popescudragosviorel-lgtm/intelligent-hybrid-power-supply/README.md

# intelligent-hybrid-power-supply
Hybrid power supply system with ESP32-based monitoring and intelligent source switching.
