popescudragosviorel-lgtm/intelligent-hybrid-power-supply/scehma electrica.f.png

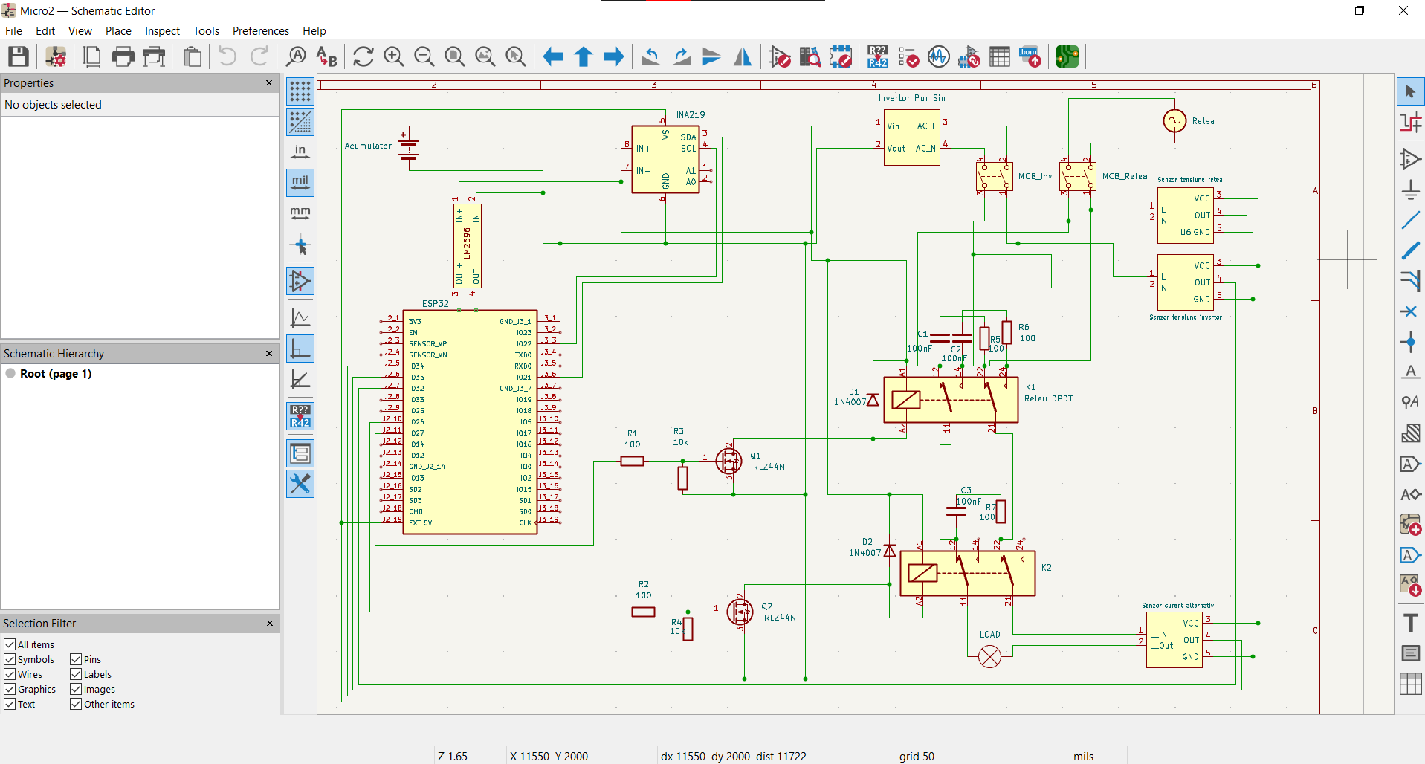
scehma electrica.f.png
