popescudragosviorel-lgtm/intelligent-hybrid-power-supply/schema bloc 2.png

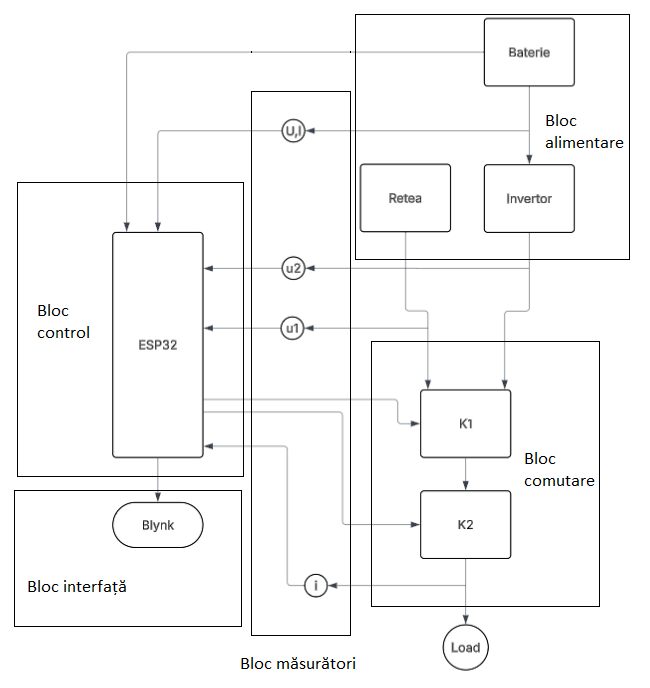
schema bloc 2.png
