popescudragosviorel-lgtm/intelligent-hybrid-power-supply/schma generala firmware.png

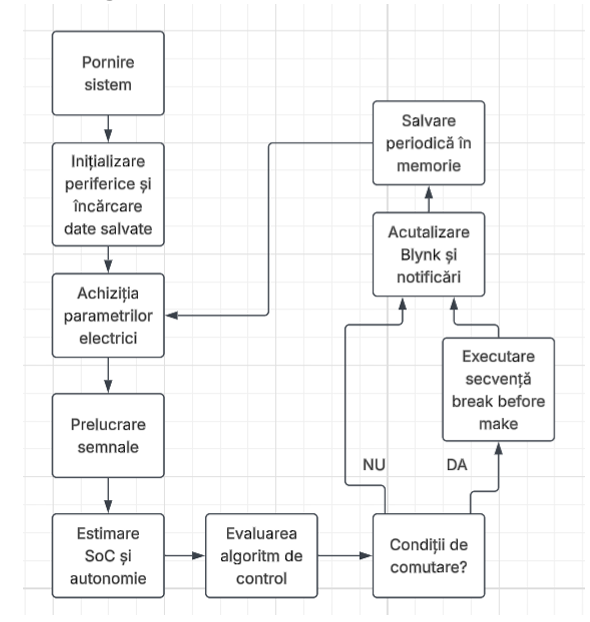
schma generala firmware.png
